FrancisCrickInstitute/Four_channel_syringe_pump/README.md

# Four_channel_syringe_pump

Four-channel syringe pump with radial distribution for 10 mL syringes

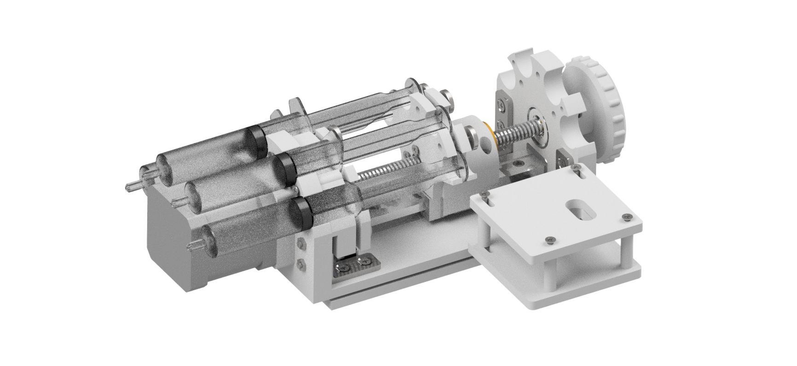
[picture p1: Design files/Inventor/Four channel pump assembly render 1.png]
