FrancisCrickInstitute/Four_channel_syringe_pump/Figures/Figure 1.png

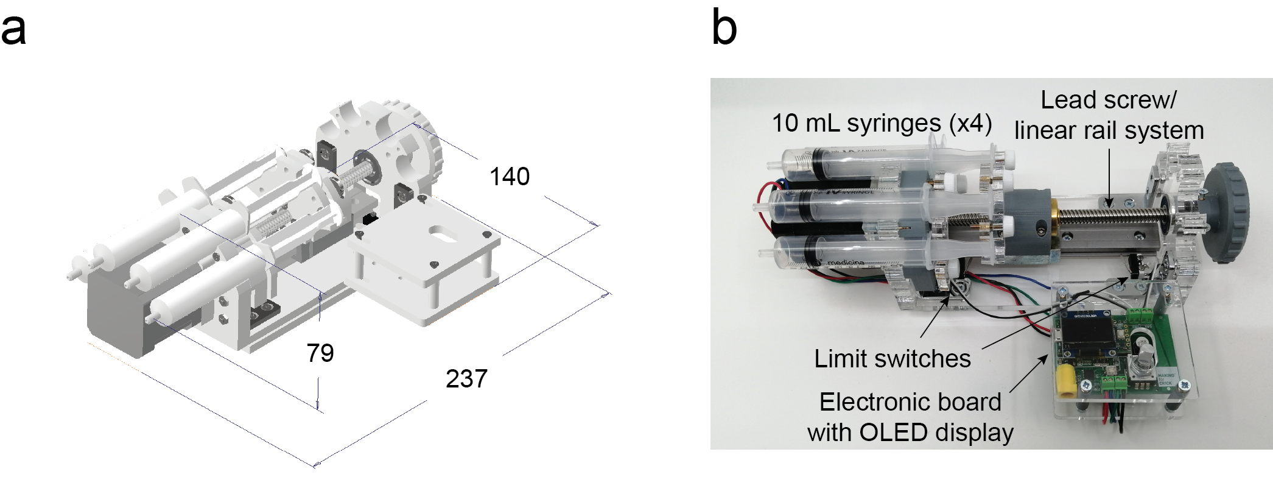
Figures/Figure 1.png
