FrancisCrickInstitute/Four_channel_syringe_pump/Figures/Figure 2.png

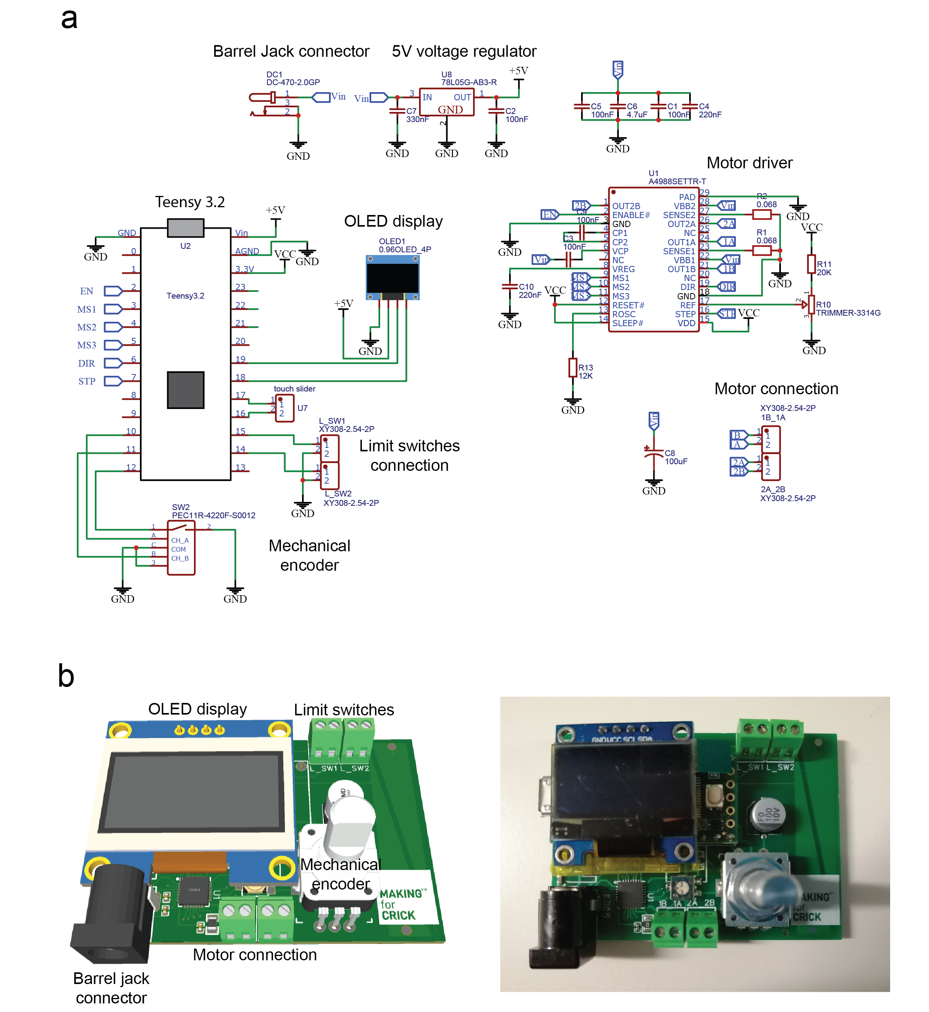
Figures/Figure 2.png
