FrancisCrickInstitute/Four_channel_syringe_pump/Figures/Figure 3.png

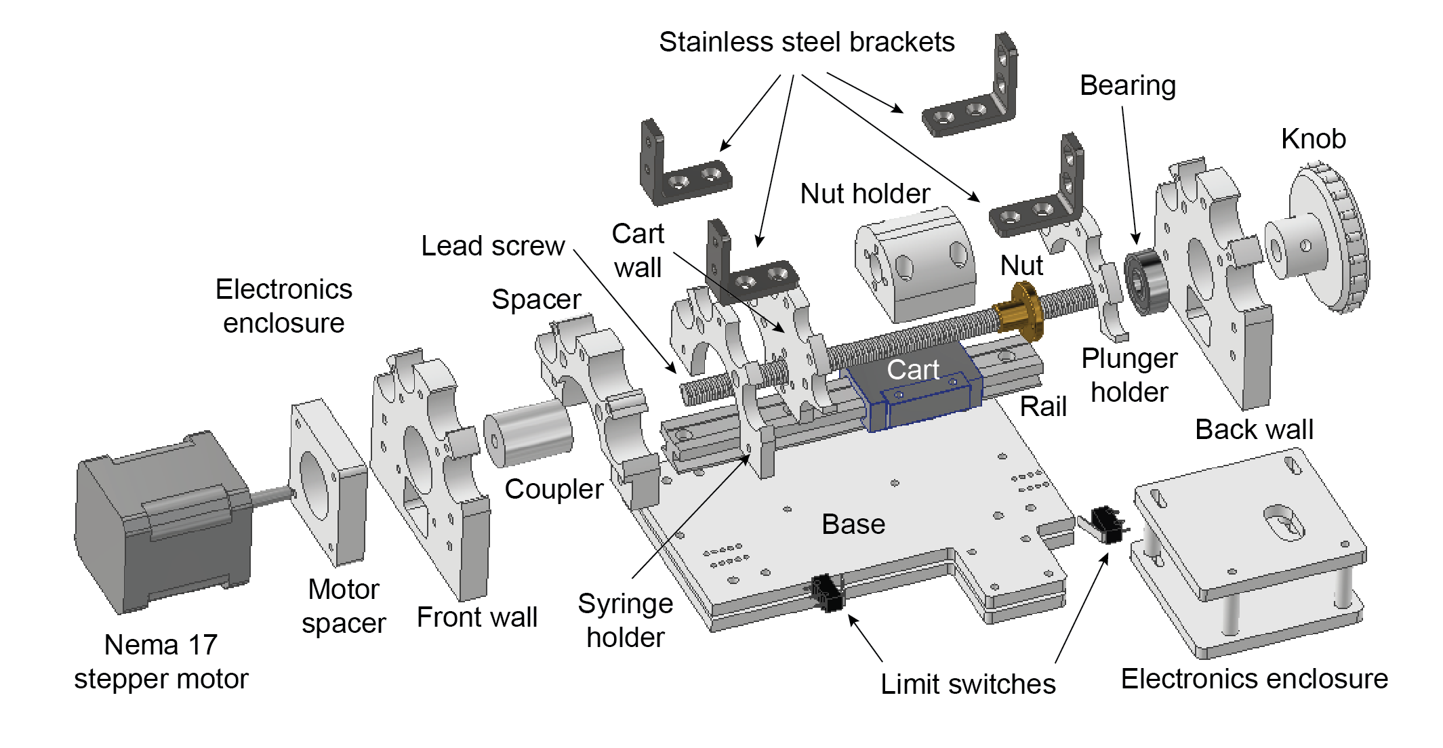
Figures/Figure 3.png
