FrancisCrickInstitute/Four_channel_syringe_pump/Figures/Figure 4(2).png

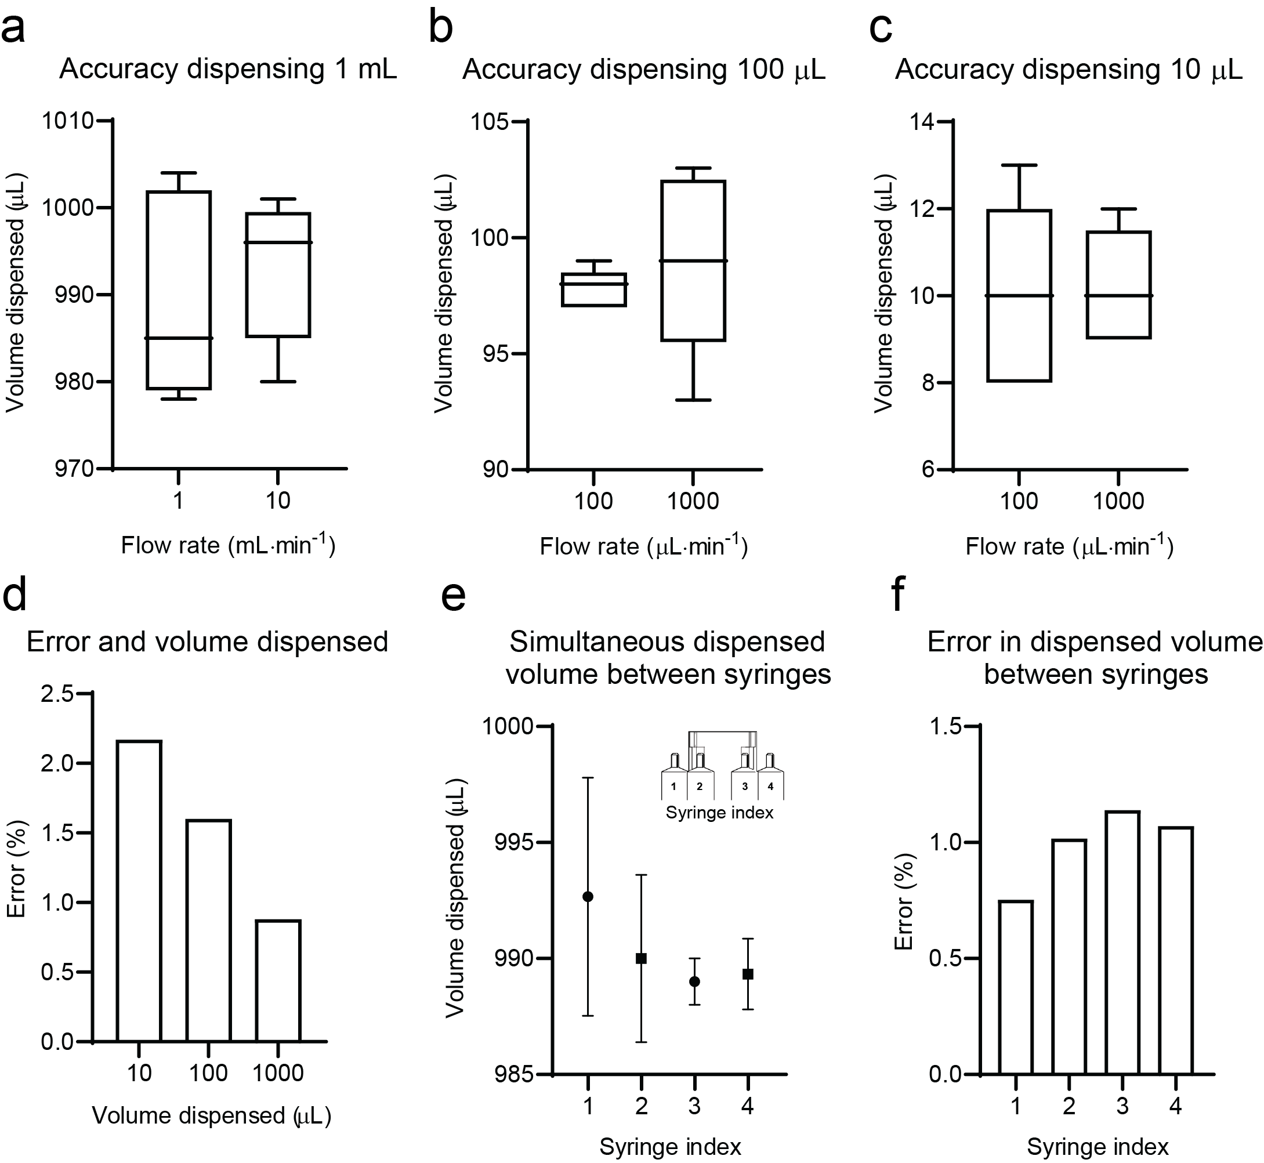
Figures/Figure 4(2).png
