FrancisCrickInstitute/Four_channel_syringe_pump/Figures/Figure 5.png

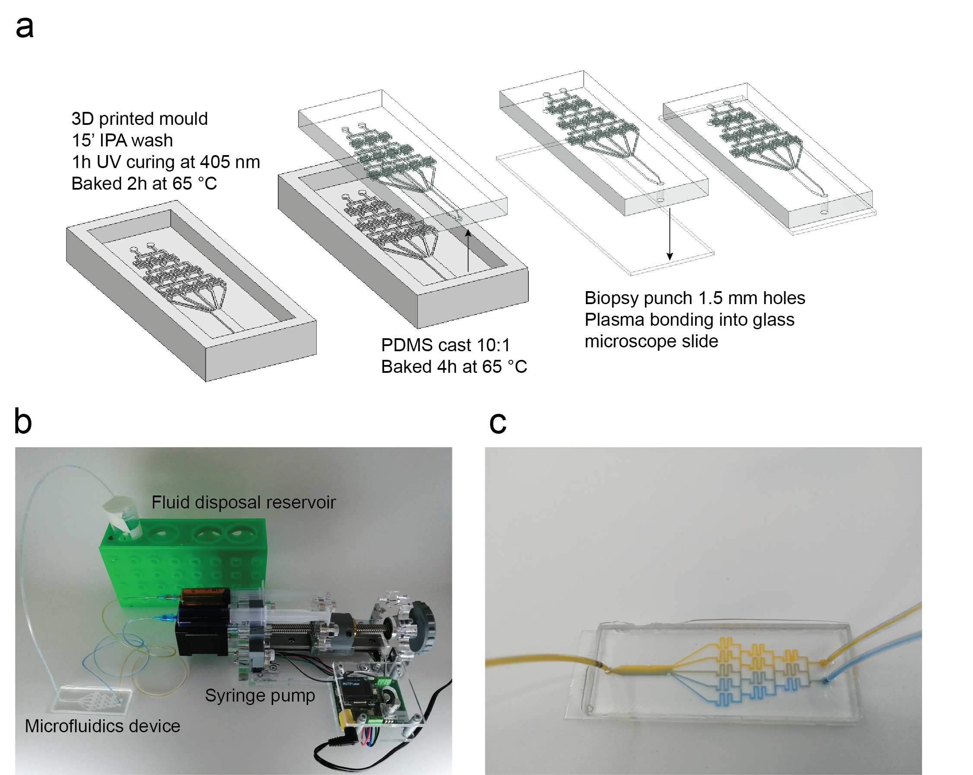
Figures/Figure 5.png
