FrancisCrickInstitute/Four_channel_syringe_pump/Figures/IMG_20210123_194944.jpg

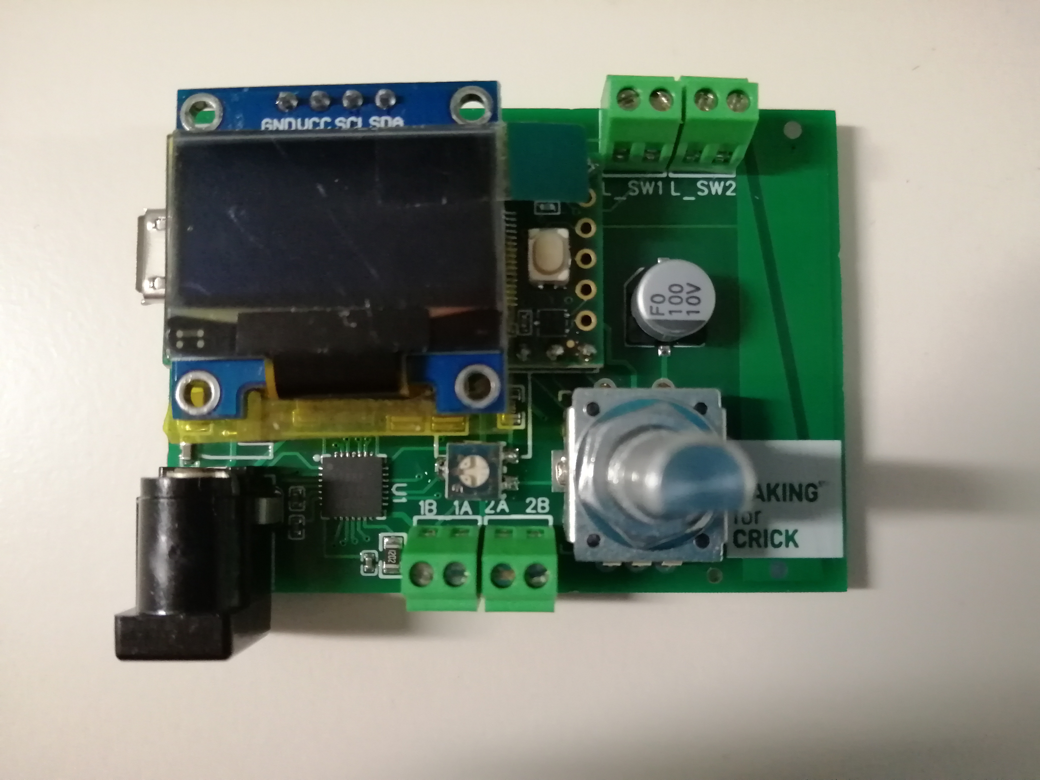
Figures/IMG_20210123_194944.jpg
