FrancisCrickInstitute/Four_channel_syringe_pump/Figures/IMG_20220202_103747.jpg

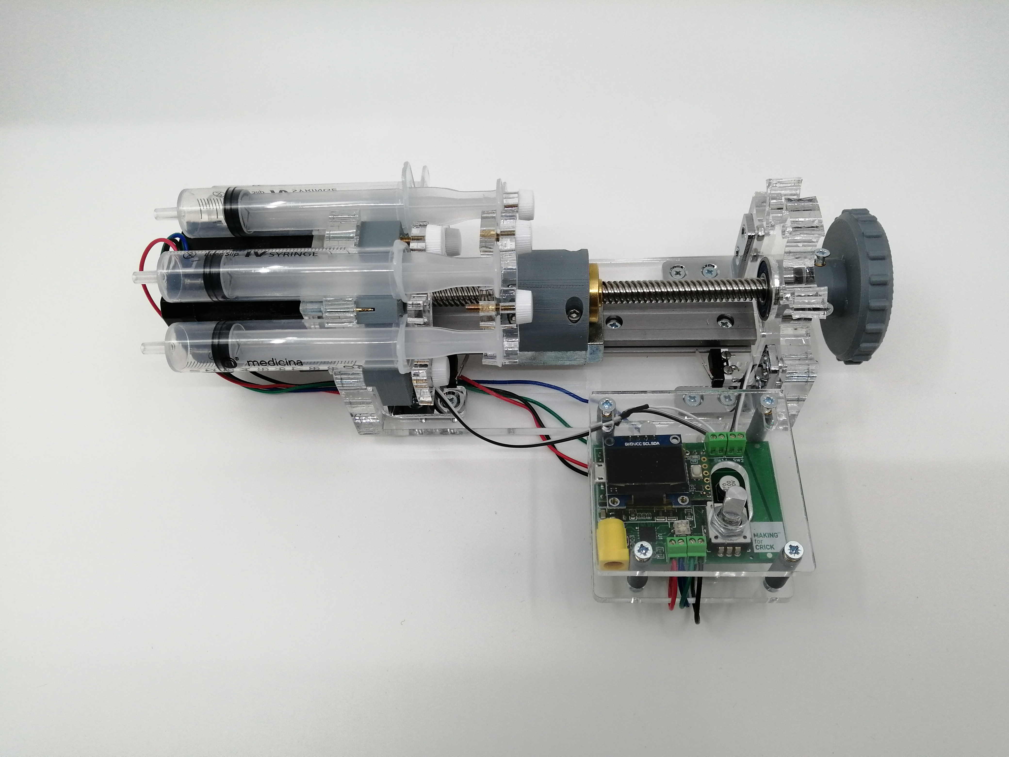
Figures/IMG_20220202_103747.jpg
