FrancisCrickInstitute/Four_channel_syringe_pump/Figures/IMG_20220818_093151.jpg

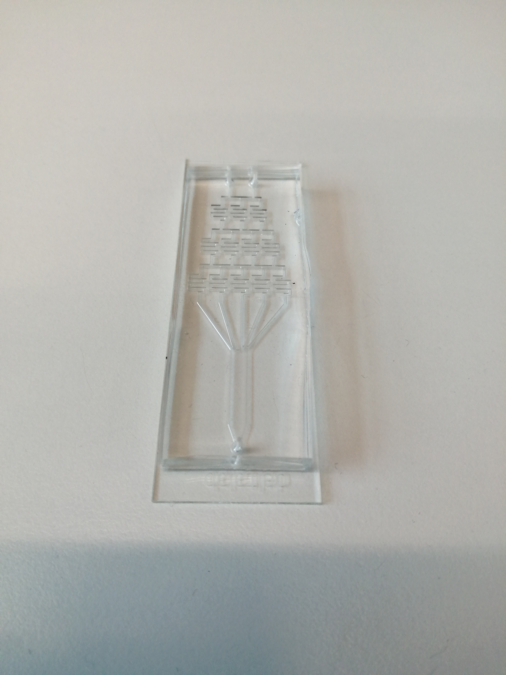
Figures/IMG_20220818_093151.jpg
