FrancisCrickInstitute/Four_channel_syringe_pump/Figures/IMG_20220916_155612.jpg

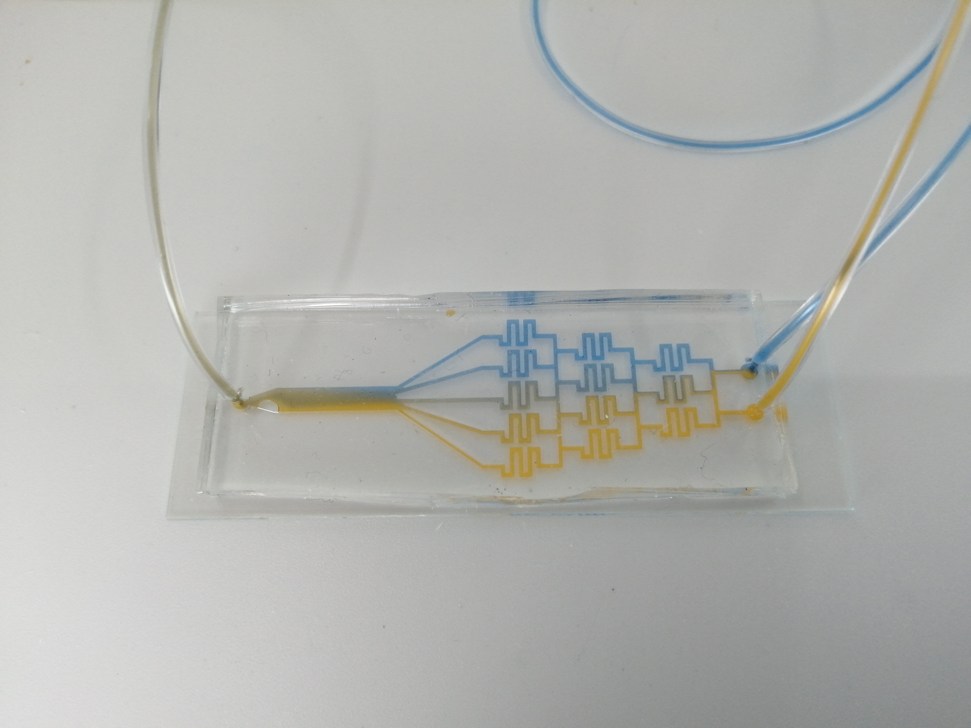
Figures/IMG_20220916_155612.jpg
