FrancisCrickInstitute/Four_channel_syringe_pump/Figures/IMG_20220930_113244.jpg

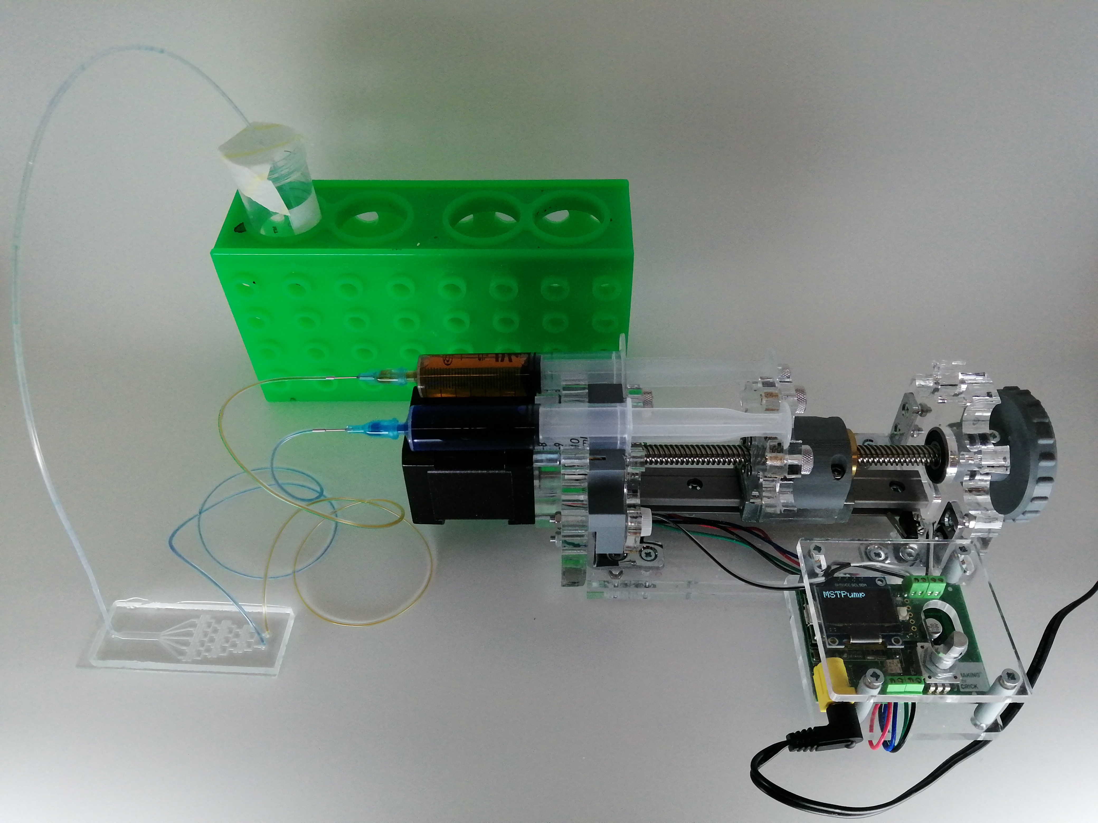
Figures/IMG_20220930_113244.jpg
