FrancisCrickInstitute/Four_channel_syringe_pump/Figures/IMG_20220930_121132.jpg

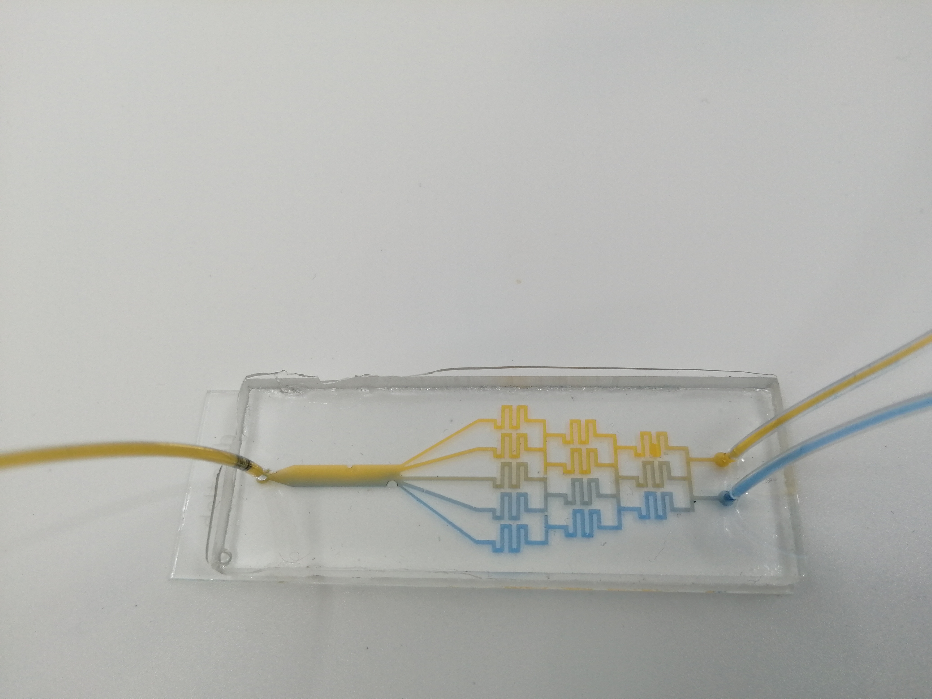
Figures/IMG_20220930_121132.jpg
