FrancisCrickInstitute/Four_channel_syringe_pump/Figures/Microfluidics gradient.png

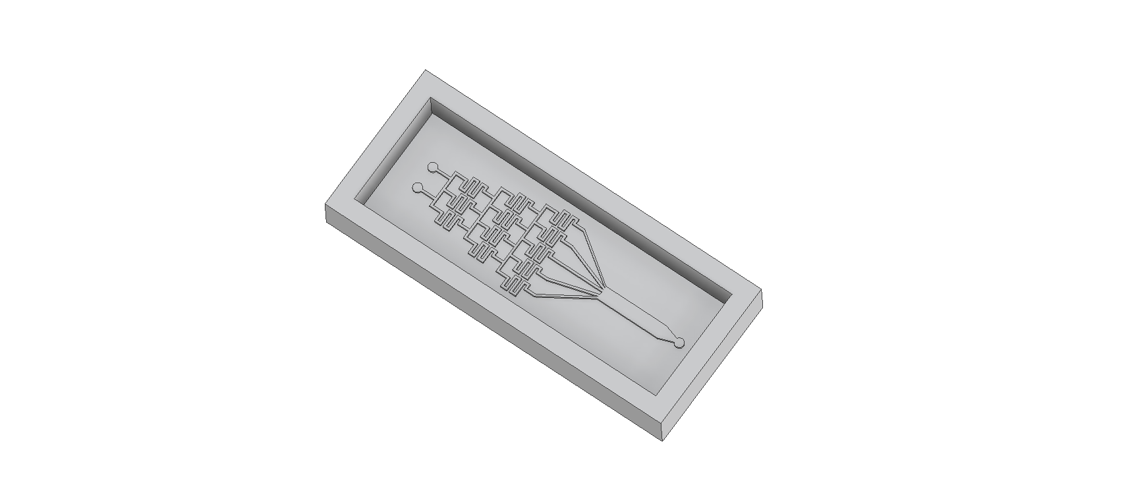
Figures/Microfluidics gradient.png
