FrancisCrickInstitute/Four_channel_syringe_pump/Bill of materials/Bill of materials.xlsx

Component | Units | Manufacturer Hyperlink embedded) | Unit cost £ | Cost £
Rail | 1 | RS Components (https://uk.rs-online.com/web/p/linear-guides-rails/4885079/) | 21.22 | 21.22
Carriage | 1 | RS Components (https://uk.rs-online.com/web/p/linear-guide-blocks/4884997/) | 24.30 | 24.30
Bracket | 4 | RS Components (https://uk.rs-online.com/web/p/enclosure-mounting-brackets/7491686) | 2.93 | 11.73
M3 threaded insert | 17 | RS Components (https://uk.rs-online.com/web/p/threaded-inserts/0278534) | 0.13 | 2.21
M3 thumb screw | 6 | RS Components (https://uk.rs-online.com/web/p/thumb-screws/6644892) | 0.14 | 0.83
Potentiometer 10k | 1 | RS Components (https://uk.rs-online.com/web/p/trimmer-potentiometers/4867526?matchtype=&pla-531626548992) | 1.45 | 1.45
Rotary encoder | 1 | RS Components (https://uk.rs-online.com/web/p/mechanical-rotary-encoders/7816830) | 1.62 | 1.62
M3 40 mm screws | 8 | Amazon (https://www.amazon.co.uk/40mm-Slot-Countersunk-Machine-Screw/dp/B07MY6HNMK) | 0.30 | 2.40
AC/DC Converter | 1 | Amazon (https://www.amazon.co.uk/Adapter-Converter-Driver-100-240V-Transformer/dp/B09DYDRFKZ) | 6.59 | 6.59
Micro Switch | 2 | Amazon (https://www.amazon.co.uk/gp/product/B07YDFH7H3/ref=ppx_yo_dt_b_asin_title_o07_s02?ie=UTF8&psc=1) | 0.30 | 0.60
OLED Display | 1 | Amazon (https://www.amazon.co.uk/gp/product/B01L9GC470/ref=ppx_yo_dt_b_asin_title_o01_s00?ie=UTF8&psc=1) | 4.99 | 4.99
Lead screw + nut (1mm) (Option B) | 1 | Amazon (https://www.amazon.co.uk/gp/product/B08M36BWMP/ref=ppx_yo_dt_b_asin_title_o02_s00?ie=UTF8&th=1) | 14.80 | 14.80
Lead screw + nut (8mm) (Option A) | 1 | Amazon (https://www.amazon.co.uk/gp/product/B07P6HQMHT/ref=ppx_yo_dt_b_asin_title_o03_s00?ie=UTF8&th=1) | 14.99 | 14.99
Coupler | 1 | Amazon (https://www.amazon.co.uk/gp/product/B0783QQMKP/ref=ppx_yo_dt_b_asin_title_o03_s00?ie=UTF8&psc=1) | 5.74 | 5.74
Nema 17 stepper motor | 1 | Amazon (https://www.amazon.co.uk/JoyNano-Stepper-Bipolar-Holding-2-Phase/dp/B07DPFP4ZK?s=industrial) | 14.99 | 14.99
Bearing | 1 | Amazon (https://www.amazon.co.uk/CODIRATO-Skateboard-Bearings-Longboard-Skateboards/dp/B07TB6Y9ZK?pd_r) | 0.45 | 0.45
Teensy 3.2 | 1 | Amazon (https://www.amazon.co.uk/Teensy-3-2-Without-Pins/dp/B018EFDXT2) | 22.99 | 22.99
M2/M3 screws | 1 | Amazon (https://www.amazon.co.uk/Loscrew-Stainless-Hexagonal-Countersunk-Assortment/dp/B08MQ8VM89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) | 21.99 | 21.99
Screw connectors | 4 | Amazon (https://www.amazon.co.uk/UCTOP-STORE-2-54mm-Terminal-Connector/dp/B01FS4KDN6) | 0.33 | 1.33
2.54 mm Female pin header | 2 | Amazon (https://www.amazon.co.uk/HALJIA-Header-Connector-2-54mm-StripWires/dp/B06WD34L1H) | 0.50 | 1.00
Barrel jack | 1 | Amazon (https://www.amazon.co.uk/Bottam-Power-Socket-2-1mm-Barrel-Type/dp/B09MQTLXJK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) | 0.10 | 0.10
Assembled PCB | 1 | Gerber file (JCB PCB) (https://cart.jlcpcb.com/quote?orderType=1&stencilLayer=2&stencilWidth=100&stencilLength=100) | 10.00 | 10.00
Spacer | 1 | 3D printed | 2.10 | 2.10 | Corresponds to 70g of filament required on our slicer simulation to print the four parts
Electronics spacer | 4 | 3D printed
Nut holder | 1 | 3D printed
Knob | 1 | 3D printed
Back wall | 2 | Laser cut/3D printed (https://www.sheetplastics.co.uk/5mm-clear-acrylic-sheet-cut-to-size) | 9.36 | 9.36 | Corresponds to a 500 x 300 mm x 5 mm Acrylic sheet needed to manufacture the parts
Base | 2 | Laser cut/3D printed
Syringe holder | 1 | Laser cut/3D printed
Plunge holder | 1 | Laser cut/3D printed
Motor spacer | 2 | Laser cut/3D printed
Front wall | 2 | Laser cut/3D printed
Electronics base | 1 | Laser cut/3D printed
Electronics cover | 1 | Laser cut/3D printed
Cart wall | 1 | Laser cut/3D printed
 |  |  | Total cost | 182.78
