FrancisCrickInstitute/Four_channel_syringe_pump/Assembly instructions/Assembly parts.png

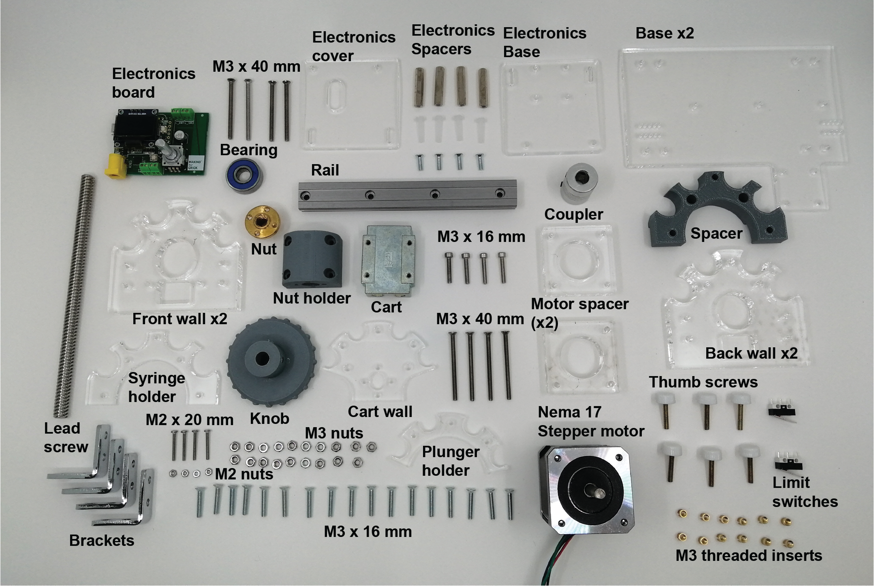
Assembly instructions/Assembly parts.png
