FrancisCrickInstitute/Four_channel_syringe_pump/Gradient chip/Microfluidics gradient.stl

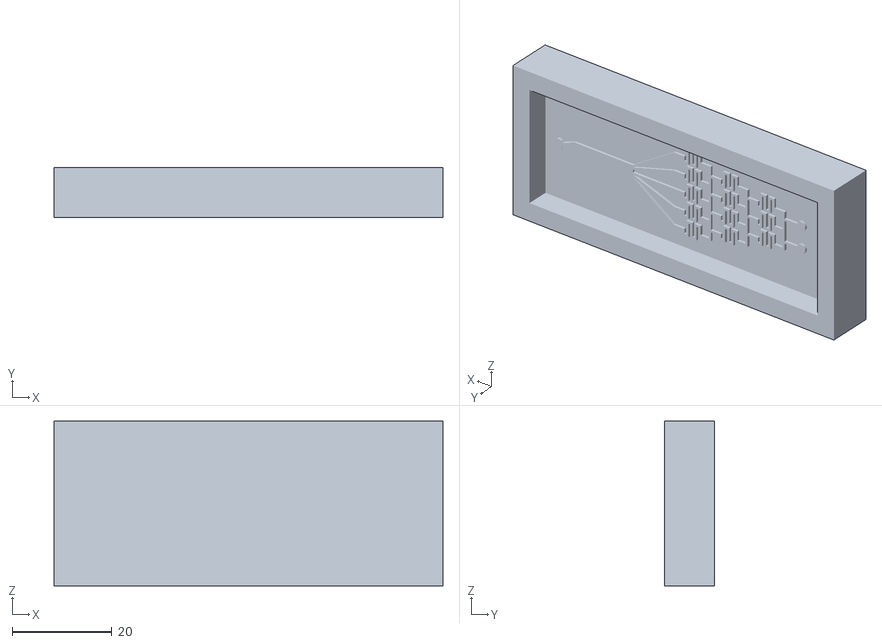
[picture p17: CAD file, 2022-09-30]
Gradient chip/Microfluidics gradient.stl
78.0 x 10.0 x 33.0
