FrancisCrickInstitute/Four_channel_syringe_pump/Manufacturing files/Mechanics/STL/Motor spacer.stl

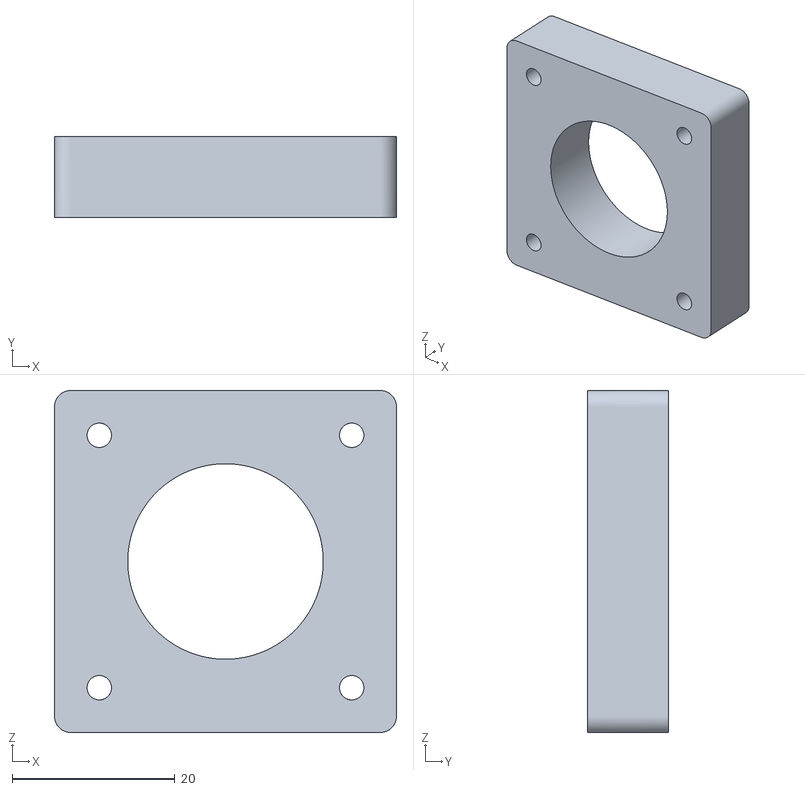
[picture p18: CAD file, 2022-02-14]
Manufacturing files/Mechanics/STL/Motor spacer.stl
42.0 x 10.0 x 42.0
