FrancisCrickInstitute/Four_channel_syringe_pump/Manufacturing files/Mechanics/STL/Cart wall.stl

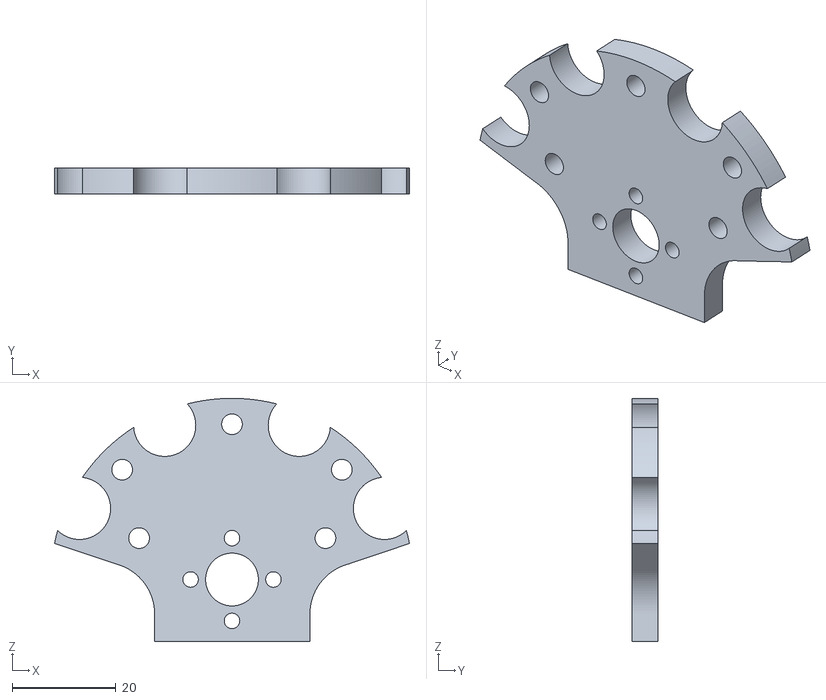
[picture p19: CAD file, 2022-02-14]
Manufacturing files/Mechanics/STL/Cart wall.stl
68.6 x 5.10 x 47.0
