FrancisCrickInstitute/Four_channel_syringe_pump/Manufacturing files/Mechanics/STL/Bracket .stl

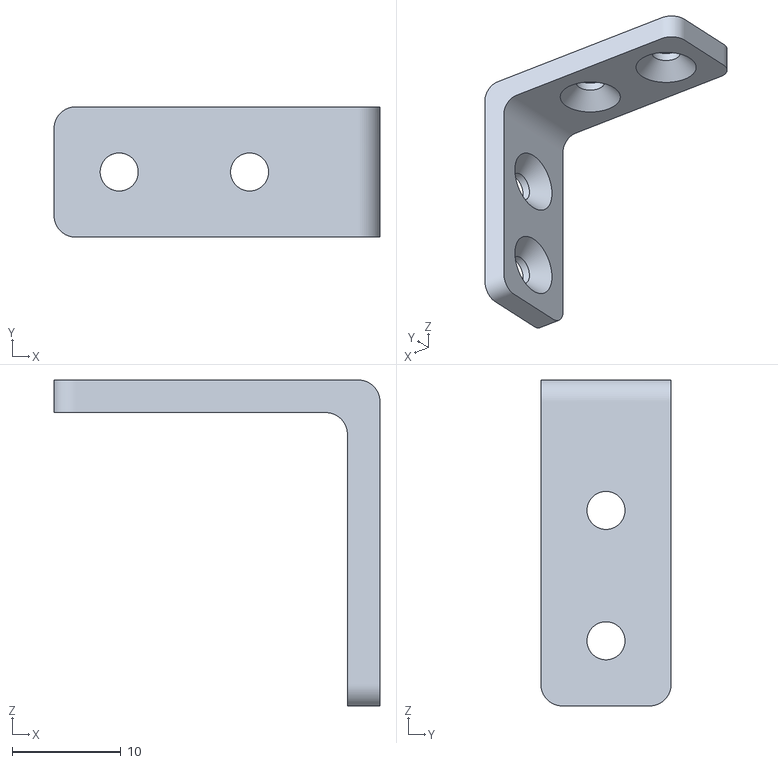
[picture p21: CAD file, 2022-02-14]
Manufacturing files/Mechanics/STL/Bracket .stl
30.0 x 12.0 x 30.0
