FrancisCrickInstitute/Four_channel_syringe_pump/Manufacturing files/Mechanics/STL/Front wall.stl

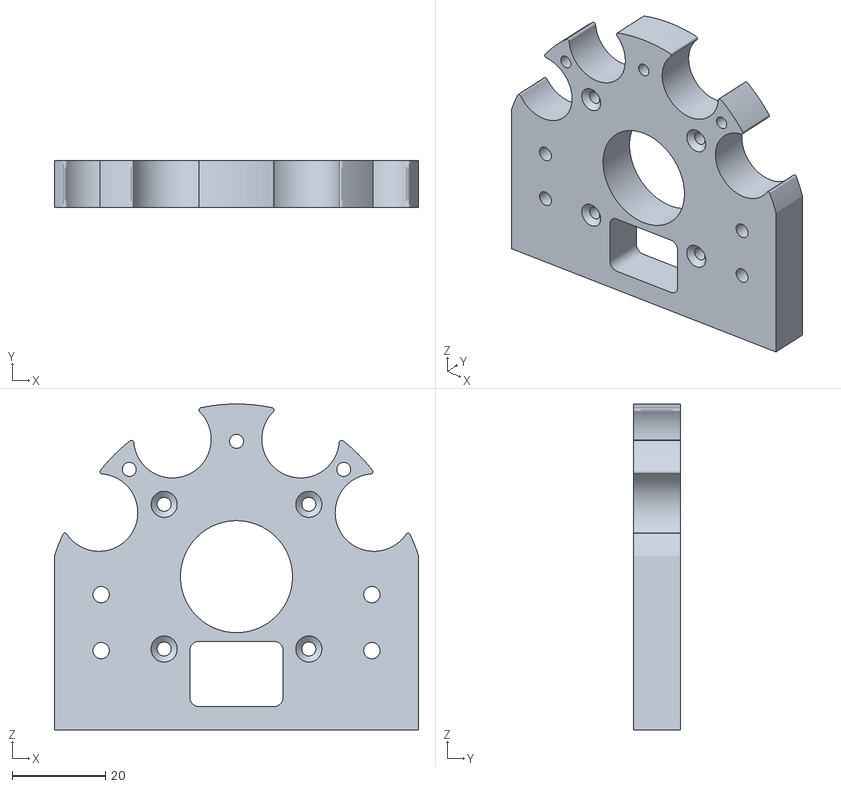
[picture p22: CAD file, 2022-02-14]
Manufacturing files/Mechanics/STL/Front wall.stl
78.0 x 10.0 x 69.8
