FrancisCrickInstitute/Four_channel_syringe_pump/Manufacturing files/Mechanics/STL/Plunger Holder.stl

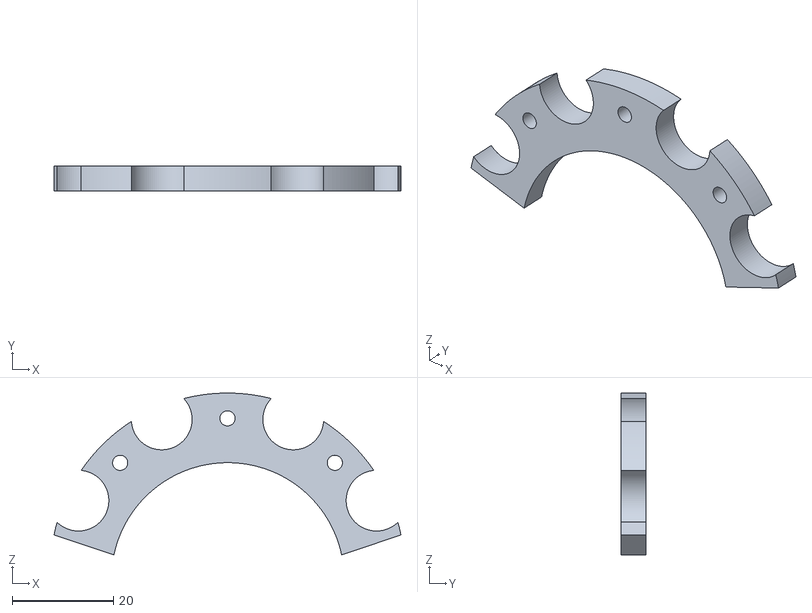
[picture p23: CAD file, 2022-02-14]
Manufacturing files/Mechanics/STL/Plunger Holder.stl
68.6 x 5.00 x 32.0
