FrancisCrickInstitute/Four_channel_syringe_pump/Manufacturing files/Mechanics/STL/Syringe Holder.stl

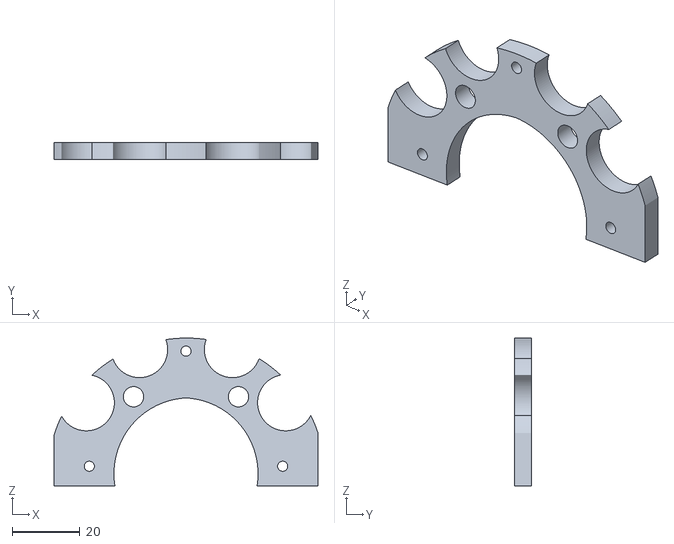
[picture p24: CAD file, 2022-02-14]
Manufacturing files/Mechanics/STL/Syringe Holder.stl
78.0 x 5.00 x 43.7
