FrancisCrickInstitute/Four_channel_syringe_pump/Manufacturing files/Mechanics/STL/Electronics base.stl

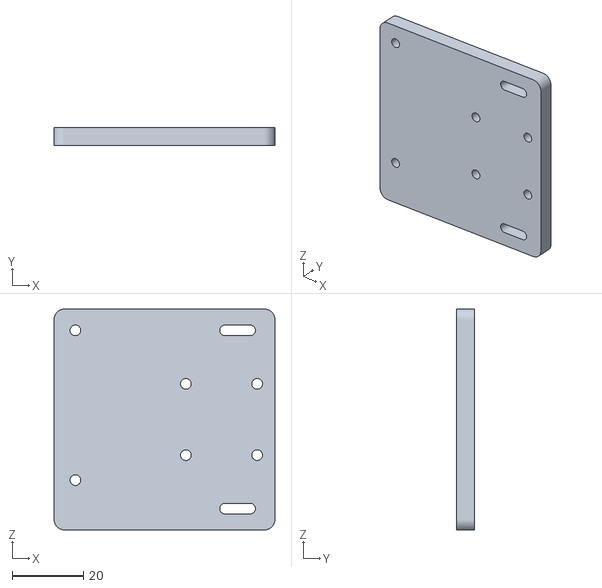
[picture p25: CAD file, 2022-02-14]
Manufacturing files/Mechanics/STL/Electronics base.stl
62.0 x 5.00 x 62.0
