FrancisCrickInstitute/Four_channel_syringe_pump/Manufacturing files/Mechanics/STL/Spacer.stl

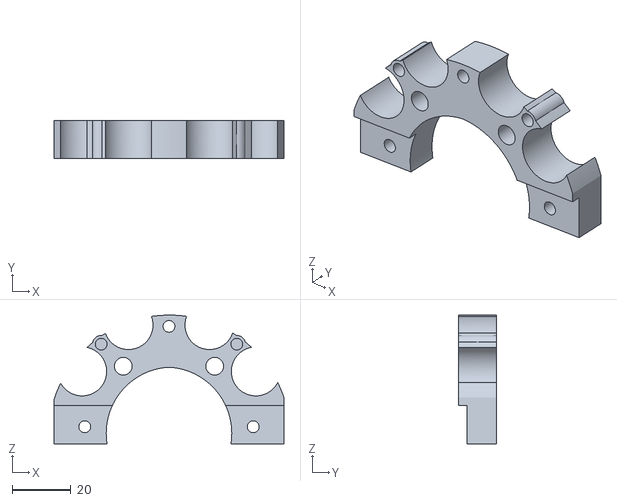
[picture p26: CAD file, 2022-02-14]
Manufacturing files/Mechanics/STL/Spacer.stl
78.0 x 13.0 x 43.7
