FrancisCrickInstitute/Four_channel_syringe_pump/Manufacturing files/Mechanics/STL/Electronics cover.stl

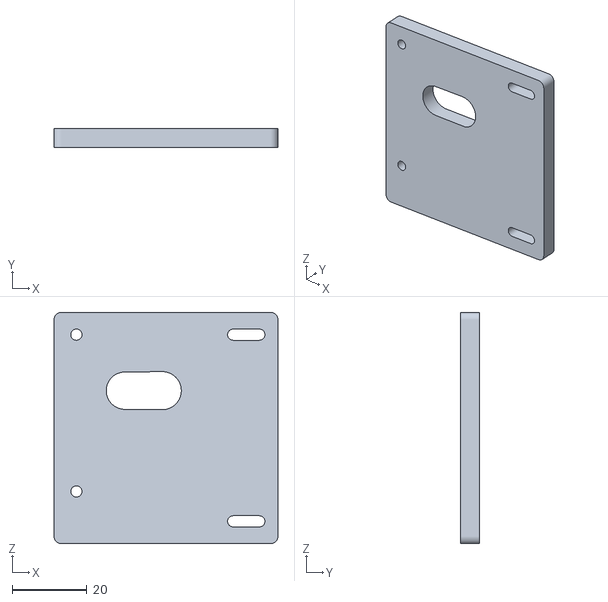
[picture p27: CAD file, 2022-02-14]
Manufacturing files/Mechanics/STL/Electronics cover.stl
60.0 x 5.00 x 62.0
