FrancisCrickInstitute/Four_channel_syringe_pump/Manufacturing files/Mechanics/STL/Knob.stl

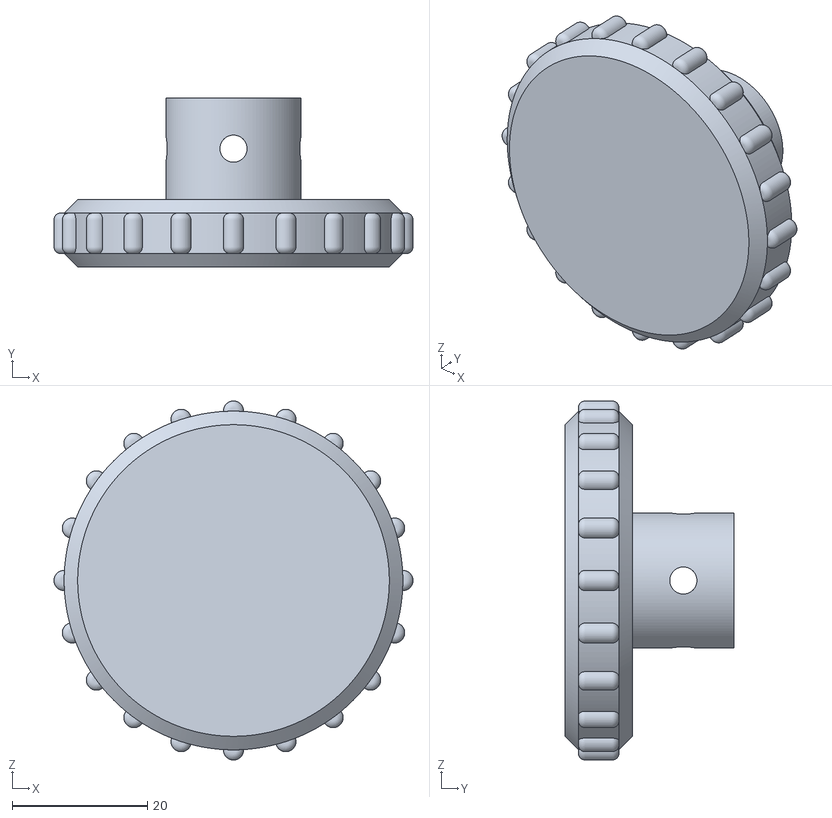
[picture p28: CAD file, 2022-02-13]
Manufacturing files/Mechanics/STL/Knob.stl
53.0 x 25.0 x 53.0
