FrancisCrickInstitute/Four_channel_syringe_pump/Manufacturing files/Mechanics/STL/Electronics spacer.stl

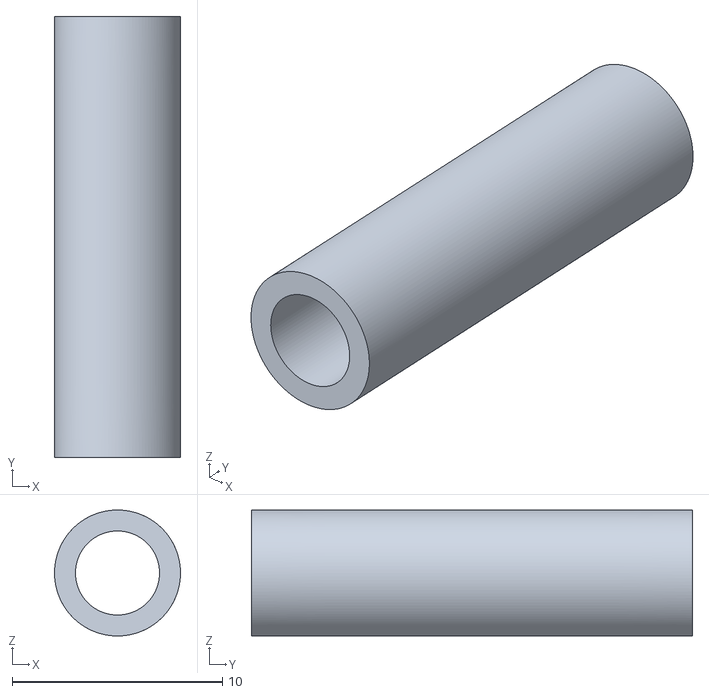
[picture p29: CAD file, 2022-02-13]
Manufacturing files/Mechanics/STL/Electronics spacer.stl
6.00 x 21.0 x 6.00
