FrancisCrickInstitute/Four_channel_syringe_pump/Manufacturing files/Mechanics/STL/Nut holder.stl

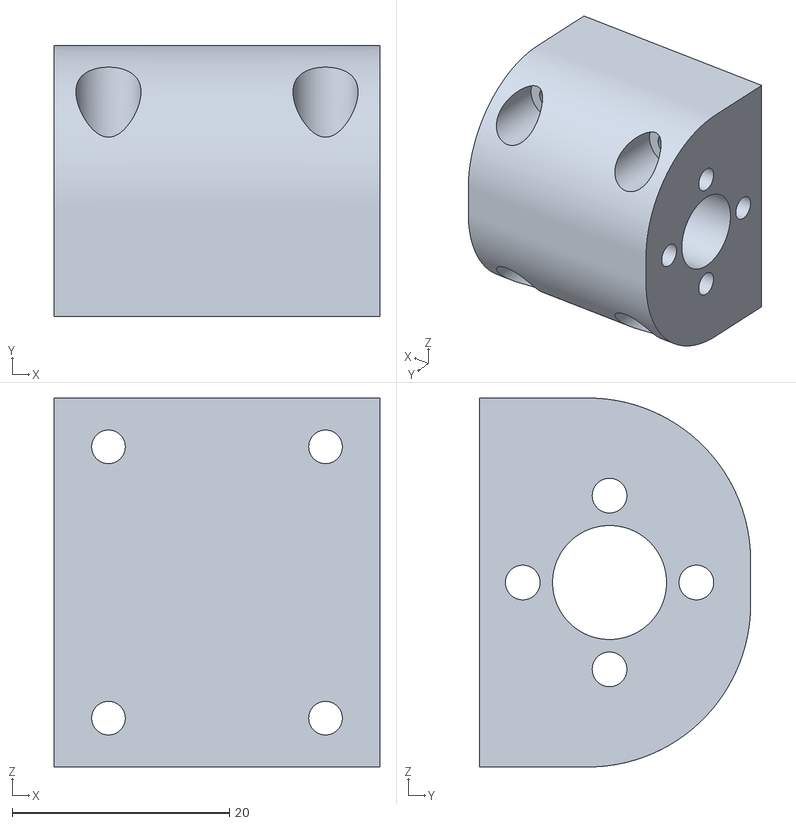
[picture p30: CAD file, 2022-02-14]
Manufacturing files/Mechanics/STL/Nut holder.stl
30.0 x 25.0 x 34.0
