FrancisCrickInstitute/Four_channel_syringe_pump/(list of files, cad)

Other CAD files:
Manufacturing files/Mechanics/STL/Back wall.stl
Design files/Inventor/10 mL syringe plunger.ipt
Design files/Inventor/10 mL syringe.ipt
Design files/Inventor/Back wall.ipt
Design files/Inventor/Base.ipt
Design files/Inventor/Bearing.ipt
Design files/Inventor/Bracket .ipt
Design files/Inventor/Cart wall.ipt
Design files/Inventor/Cart.ipt
Design files/Inventor/Coupler.ipt
Design files/Inventor/Electronics base.ipt
Design files/Inventor/Electronics cover.ipt
Design files/Inventor/Electronics spacer.ipt
Design files/Inventor/Four channel pump assembly.iam
Design files/Inventor/Four channel pump assembly.ipn
Design files/Inventor/Front wall.ipt
Design files/Inventor/Knob.ipt
Design files/Inventor/Lead screw.ipt
Design files/Inventor/Microswitch.ipt
Design files/Inventor/Motor spacer.ipt
Design files/Inventor/Nut holder.ipt
Design files/Inventor/Nut.ipt
Design files/Inventor/OldVersions/10 mL syringe plunger.0001.ipt
Design files/Inventor/OldVersions/10 mL syringe plunger.0003.ipt
Design files/Inventor/OldVersions/10 mL syringe plunger.0004.ipt
Design files/Inventor/OldVersions/10 mL syringe.0002.ipt
Design files/Inventor/OldVersions/Base.0002.ipt
Design files/Inventor/OldVersions/Cart.0001.ipt
Design files/Inventor/OldVersions/Coupler.0001.ipt
Design files/Inventor/OldVersions/Four channel pump assembly.0002.ipn
Design files/Inventor/OldVersions/Four channel pump assembly.0031.iam
Design files/Inventor/OldVersions/Front wall.0001.ipt
Design files/Inventor/OldVersions/Knob.0003.ipt
Design files/Inventor/OldVersions/Lead screw.0004.ipt
Design files/Inventor/OldVersions/Spacer.0002.ipt
Design files/Inventor/OldVersions/Syringe Holder.0001.ipt
Design files/Inventor/Plunger Holder.ipt
Design files/Inventor/Rail.ipt
Design files/Inventor/Spacer.ipt
Design files/Inventor/Stepper motor (Nema 17).ipt
Design files/Inventor/Syringe Holder.ipt
Gradient chip/Assembly1.iam
Gradient chip/Microfluidics gradient PDMS with ports.ipt
Gradient chip/Microfluidics gradient PDMS.ipt
Gradient chip/Microfluidics gradient.ipt
Gradient chip/Microscope slide.ipt
Gradient chip/OldVersions/Assembly1.0001.iam
Gradient chip/OldVersions/Microfluidics gradient PDMS.0002.ipt
Gradient chip/OldVersions/Microfluidics gradient substratr.0001.ipt
Gradient chip/OldVersions/Microfluidics gradient.0019.ipt
Gradient chip/OldVersions/Microscope slide.0002.ipt
Manufacturing files/Mechanics/DXF/Back wall.dxf
Manufacturing files/Mechanics/DXF/Base.dxf
Manufacturing files/Mechanics/DXF/Cart wall.dxf
Manufacturing files/Mechanics/DXF/Electronics base.dxf
Manufacturing files/Mechanics/DXF/Electronics cover.dxf
Manufacturing files/Mechanics/DXF/Front wall.dxf
Manufacturing files/Mechanics/DXF/Motor spacer.dxf
Manufacturing files/Mechanics/DXF/Plunger holder.dxf
Manufacturing files/Mechanics/DXF/Syringe holder.dxf
