FrancisCrickInstitute/Four_channel_syringe_pump/Manufacturing files/Electronics/Gerber/Gerber_PCB/How-to-order-PCB.txt

How to Order PCB

Please refer to:
https://docs.easyeda.com/en/PCB/Order-PCB
