FrancisCrickInstitute/Four_channel_syringe_pump/Assembly instructions/Assembly instructions.docx

1- Laser cut the parts in the file Manufacturing in 5 mm thickness Acrylic.ai (https://github.com/FrancisCrickInstitute/Four_channel_syringe_pump/blob/main/Manufacturing%20files/Mechanics/Adobe%20Illustrator/Manufacturing%20in%205%20mm%2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) which can be found on: https://github.com/FrancisCrickInstitute/Four_channel_syringe_pump/tree/main/Manufacturing%20files/Mechanics/Adobe%20Illustrator (Figure 1).

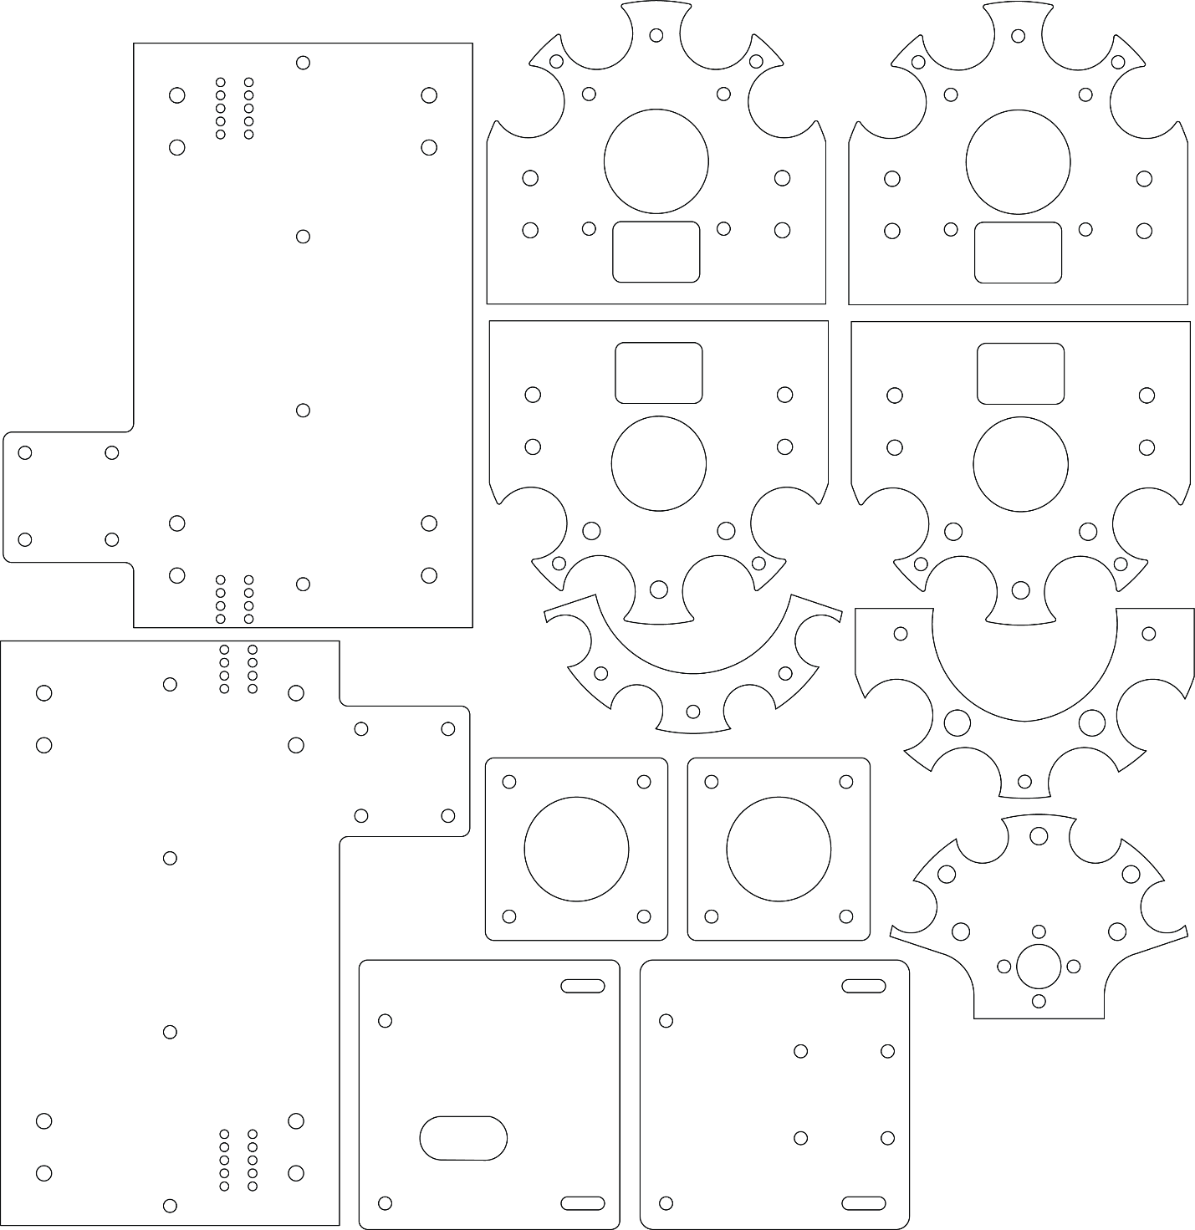
[picture p31: figure]

Figure 1: Parts to laser cut.

2- 3D print the parts (Knob.stl, Spacer.stl, Electronics spacer.stl and Nut holder.stl ) found on: https://github.com/FrancisCrickInstitute/Four_channel_syringe_pump/tree/main/Manufacturing%20files/Mechanics/STL

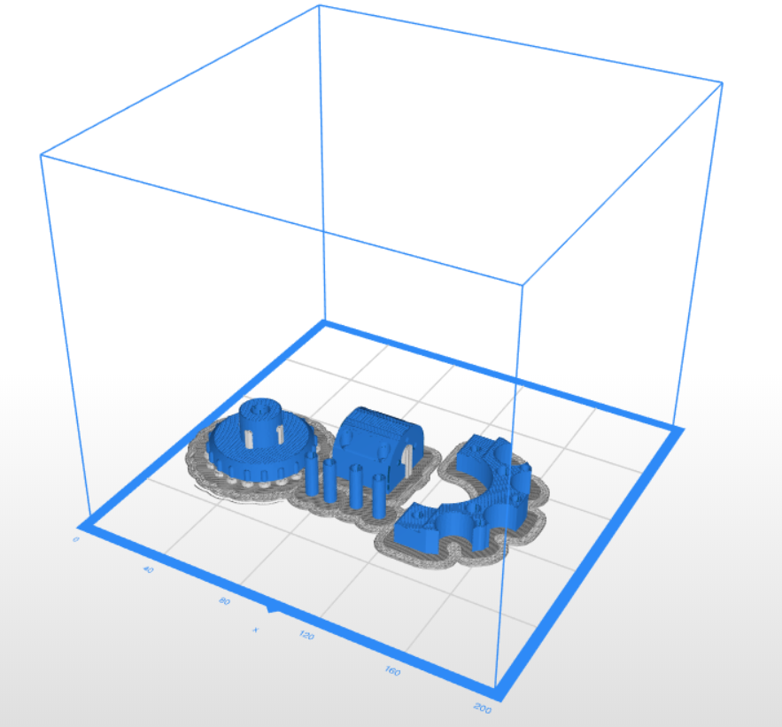
[picture p32: figure]

Figure 1: Parts to 3D print on the slicer simulation.

3- Send the electronics to manufacture:
  a. Go to JLCBPCB: https://cart.jlcpcb.com/quote?orderType=1&stencilLayer=2&stencilWidth=100&stencilLength=100
  b. Upload the Gerber files:
  c. Select SMT Assembly
  d. Upload the BOM file
  e. Upload the Pick and place file
