FrancisCrickInstitute/Four_channel_syringe_pump/Gradient chip/Assembly1.pdf

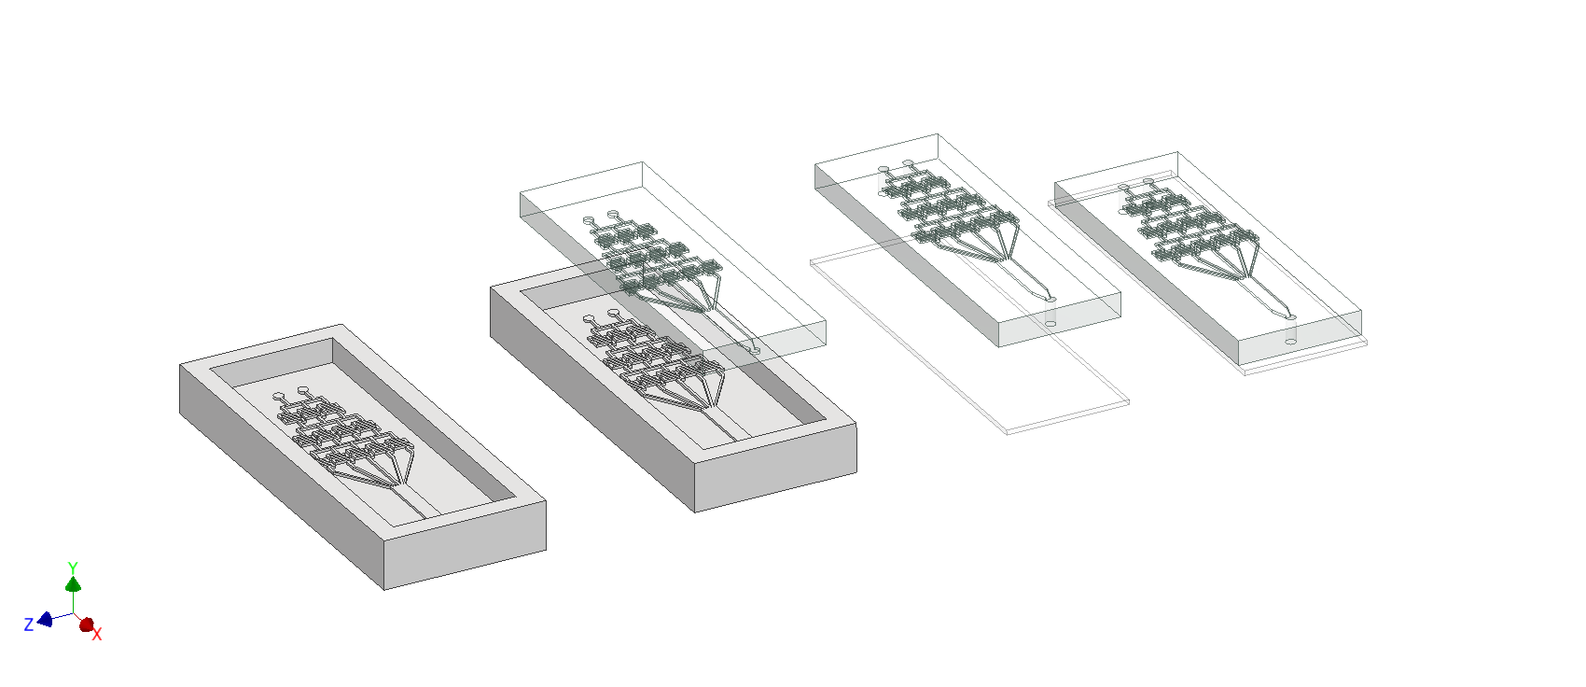
[picture p33: page 1]
