FrancisCrickInstitute/Four_channel_syringe_pump/Figures/Four channel pump assembly.pdf

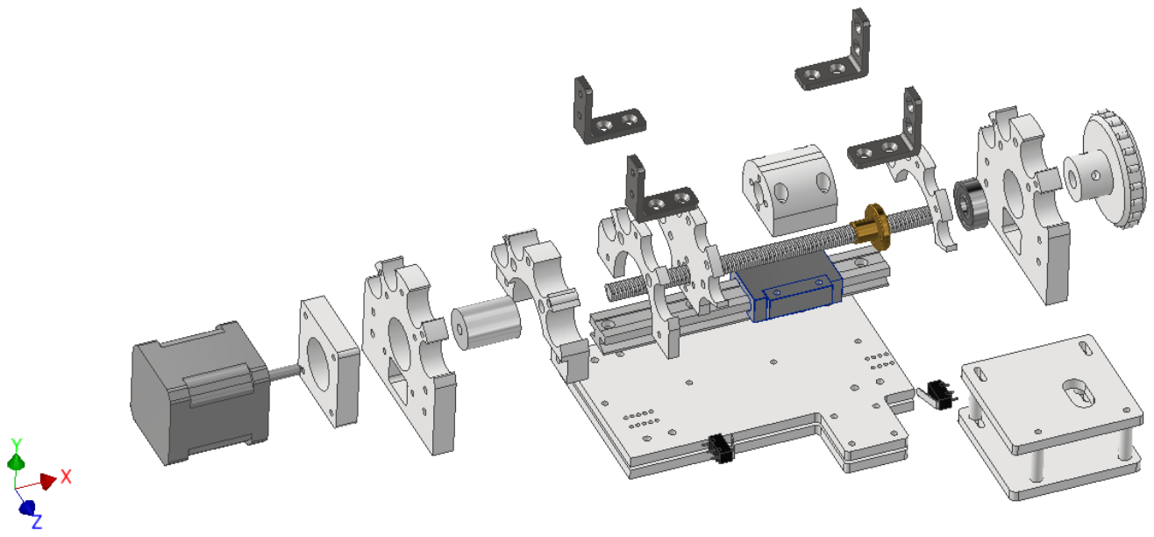
[picture p34: page 1]
