FrancisCrickInstitute/Four_channel_syringe_pump/Assembly instructions/Pictures/IMG_20220131_150504.jpg

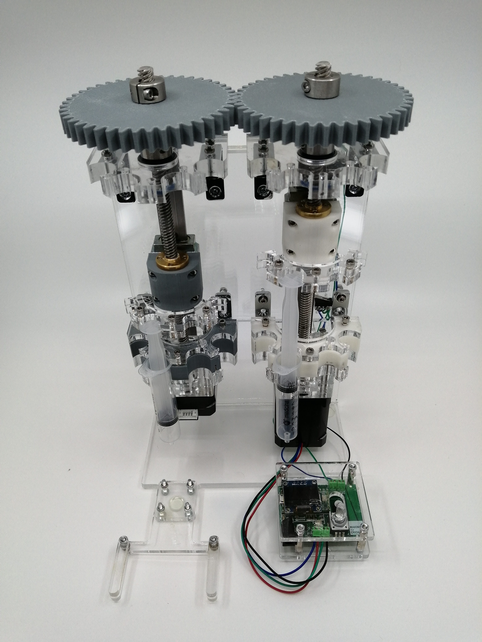
Assembly instructions/Pictures/IMG_20220131_150504.jpg
