FrancisCrickInstitute/Four_channel_syringe_pump/Assembly instructions/Pictures/IMG_20220201_115702.jpg

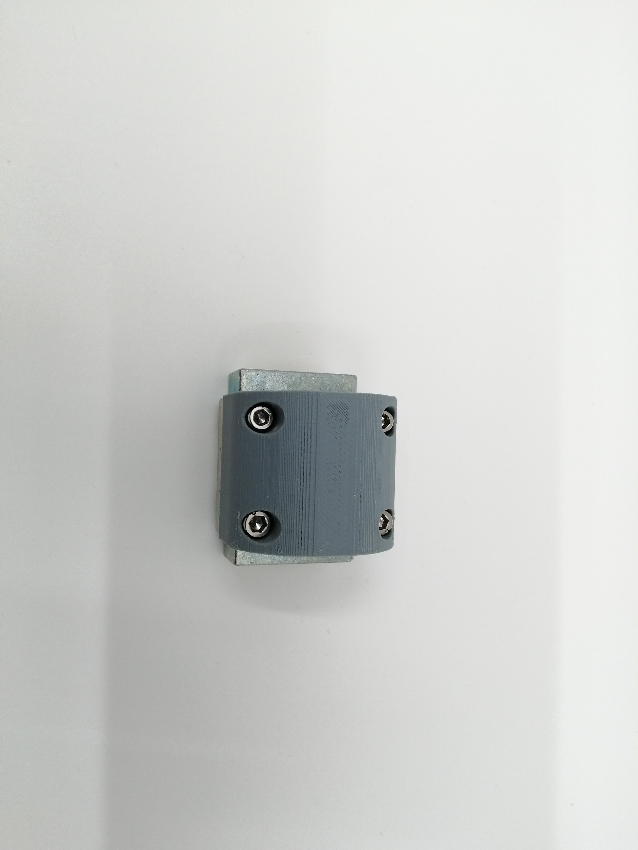
Assembly instructions/Pictures/IMG_20220201_115702.jpg
