FrancisCrickInstitute/Four_channel_syringe_pump/Assembly instructions/Pictures/IMG_20220201_121818.jpg

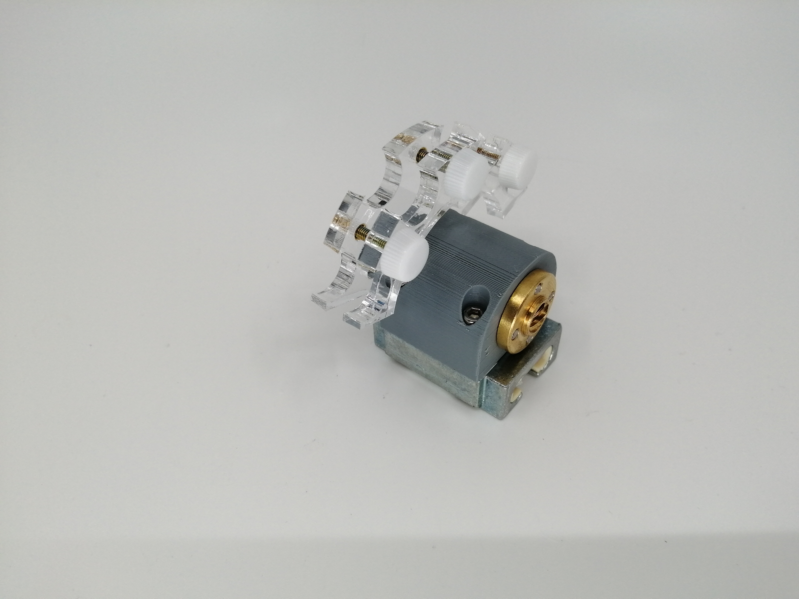
Assembly instructions/Pictures/IMG_20220201_121818.jpg
