FrancisCrickInstitute/Four_channel_syringe_pump/Assembly instructions/Pictures/IMG_20220201_134931.jpg

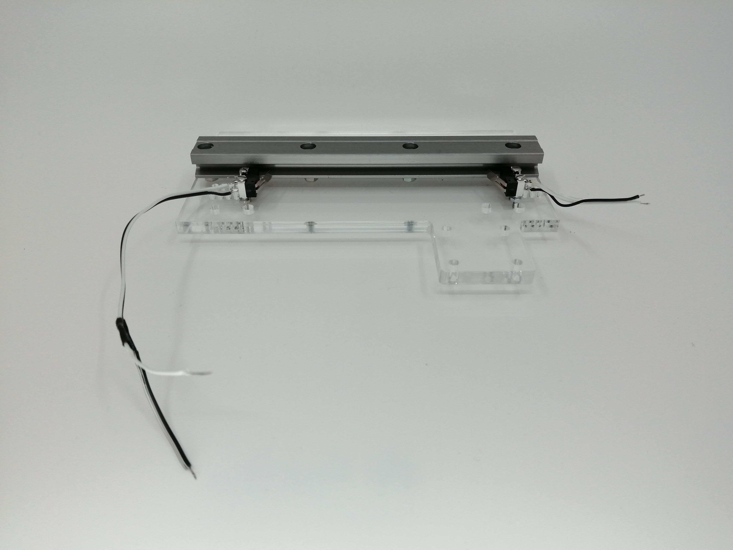
Assembly instructions/Pictures/IMG_20220201_134931.jpg
