FrancisCrickInstitute/Four_channel_syringe_pump/Assembly instructions/Pictures/IMG_20220201_173131.jpg

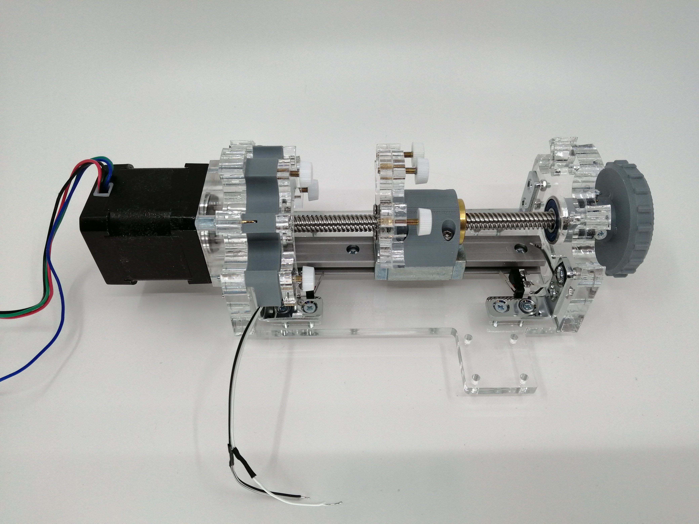
Assembly instructions/Pictures/IMG_20220201_173131.jpg
