FrancisCrickInstitute/Four_channel_syringe_pump/Assembly instructions/Pictures/IMG_20220202_101638.jpg

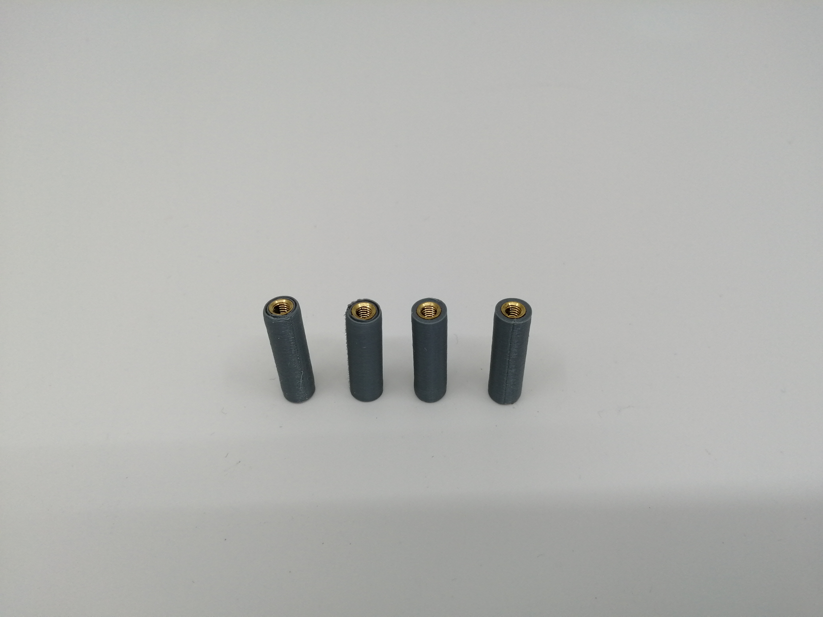
Assembly instructions/Pictures/IMG_20220202_101638.jpg
