FrancisCrickInstitute/Four_channel_syringe_pump/Assembly instructions/Threaded inserts.png

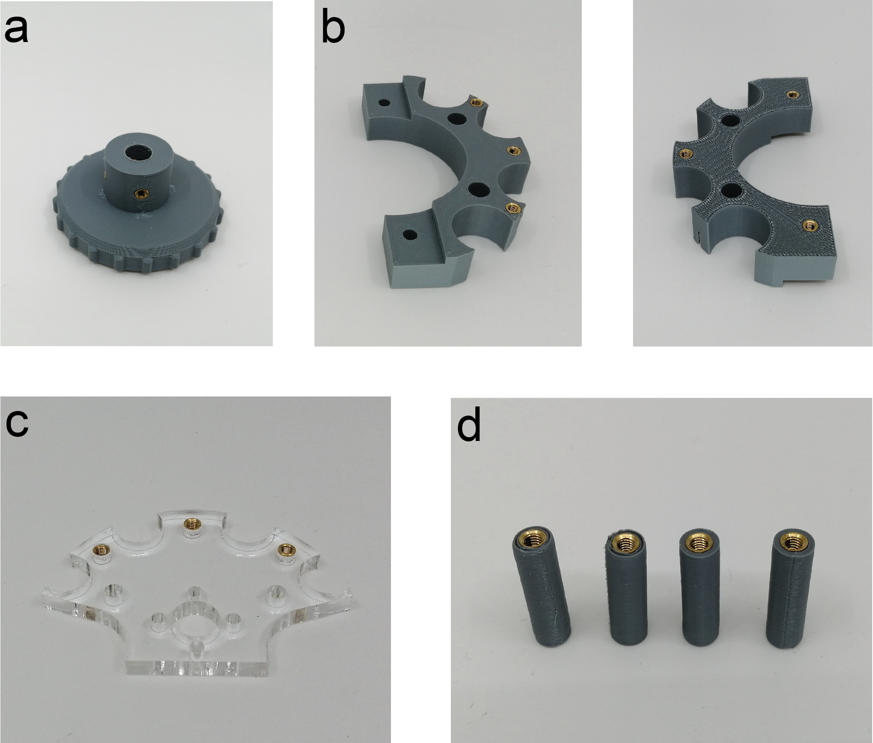
Assembly instructions/Threaded inserts.png
