FrancisCrickInstitute/Four_channel_syringe_pump/Design files/Inventor/Four channel pump assembly.png

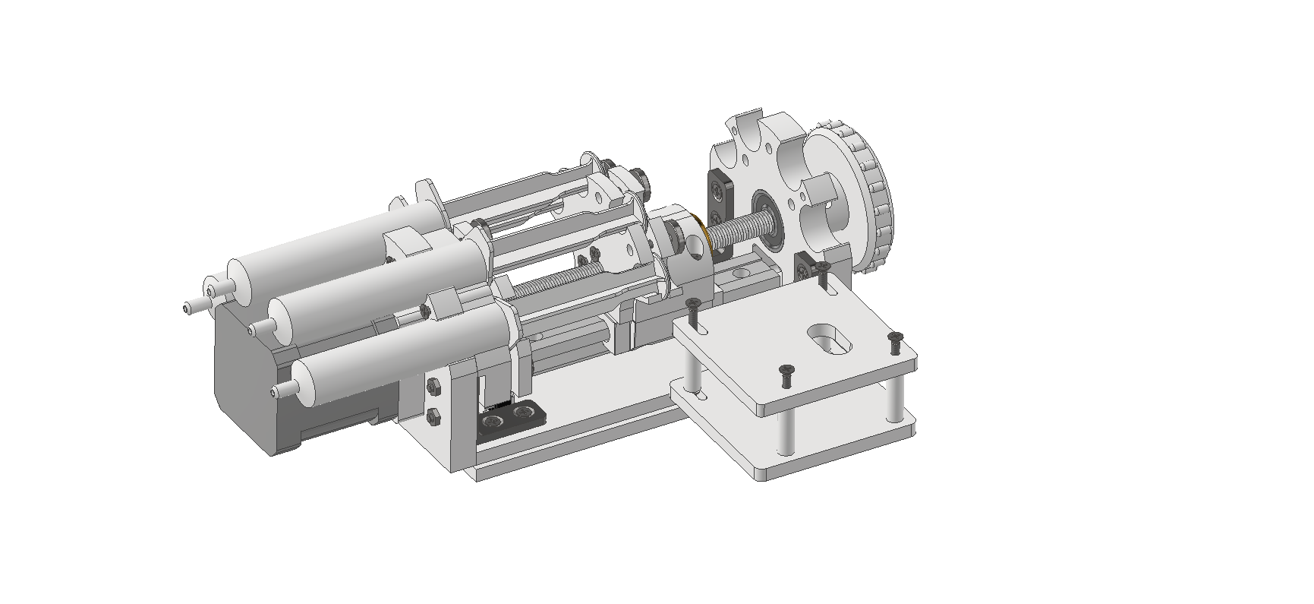
Design files/Inventor/Four channel pump assembly.png
