FrancisCrickInstitute/Four_channel_syringe_pump/Figures/Four channel pump assembly dimensions 2.png

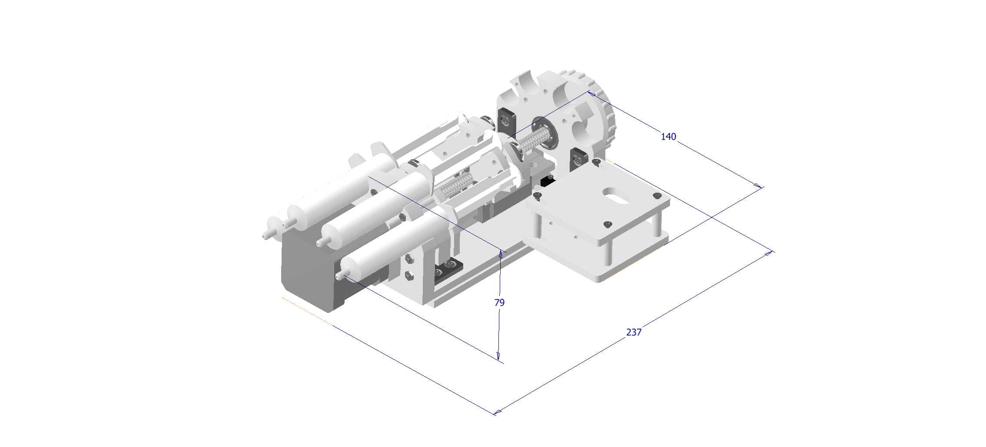
Figures/Four channel pump assembly dimensions 2.png
