FrancisCrickInstitute/Four_channel_syringe_pump/Data/4ch syringe performance.png

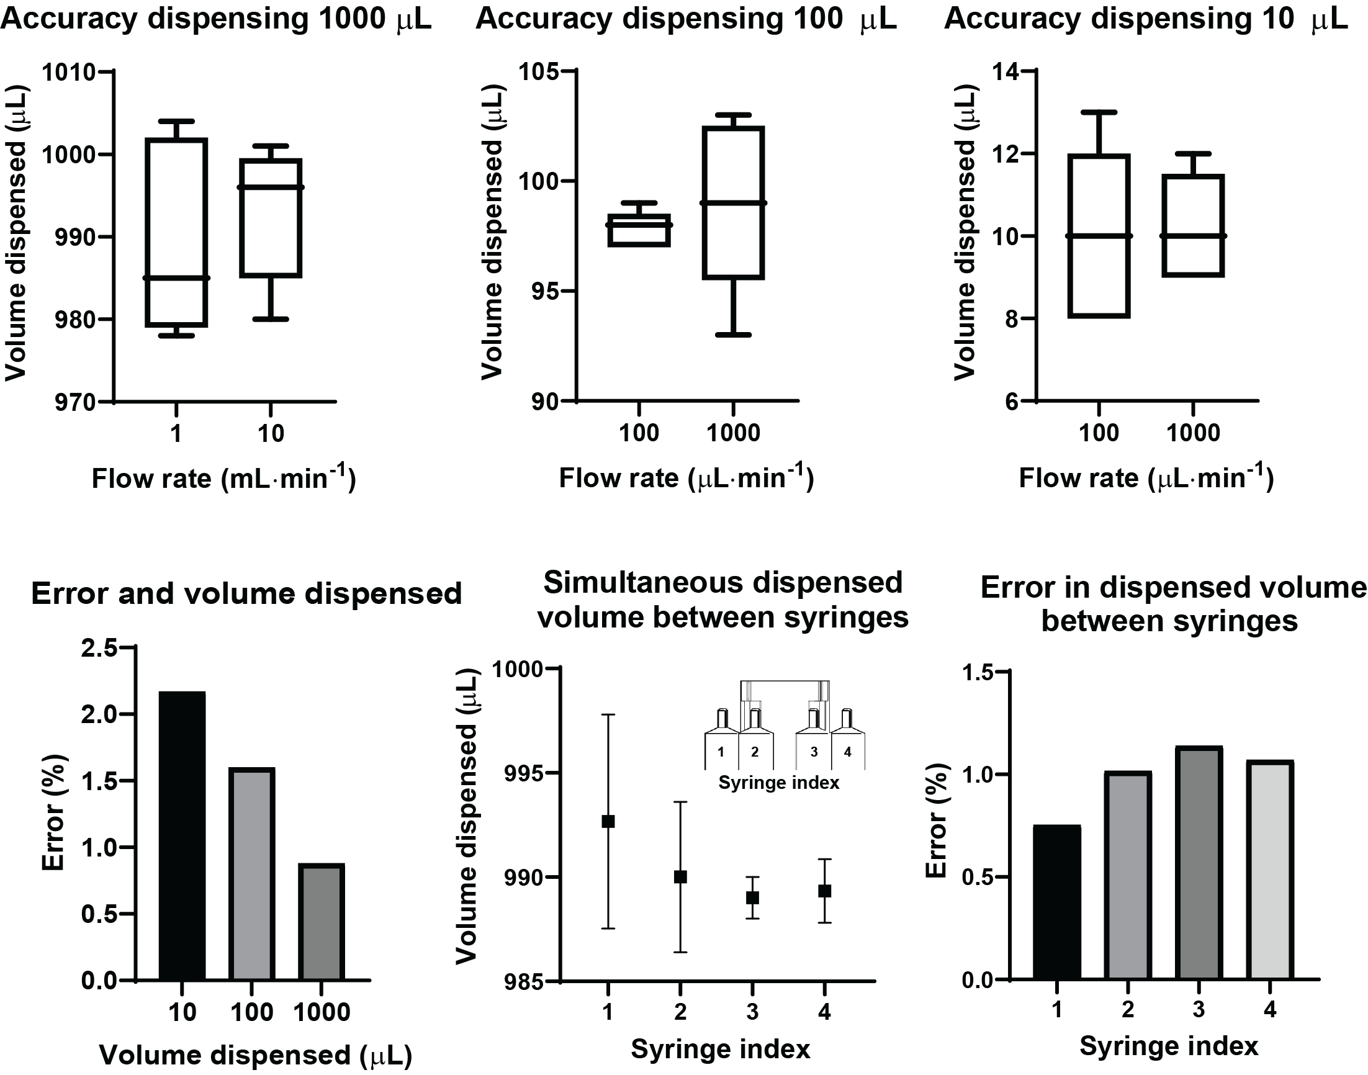
Data/4ch syringe performance.png
