FrancisCrickInstitute/Four_channel_syringe_pump/(list of files, drawings)

Other design files:
Design files/PCB/EasyEDA/1-PCB_PCB_2020-09-28_16-45-37.json
Design files/PCB/EasyEDA/1-Schematic_stepper-controller.json
