FrancisCrickInstitute/Four_channel_syringe_pump/(commit log)

2022-02-14 Second Commit
    [10 mL syringe plunger.ipt, 10 mL syringe.ipt, 4ch syringe pump.stp, Back wall.dxf, Back wall.ipt, Back wall.stl, Base.0002.ipt, Base.dxf]
2022-02-14 Assembly instructions 1
2022-02-15 BOM & PnP
    [BOM_PCB.csv, Bill of materials.xlsx, PickAndPlace_PCB.csv]
2022-02-15 Assembly instructions 2
    [Bill of materials.xlsx]
2022-02-16 Ipt assembly
    [10 mL syringe plunger.0001.ipt, 10 mL syringe plunger.0003.ipt, 10 mL syringe plunger.0004.ipt, 10 mL syringe plunger.ipt, 10 mL syringe.0002.ipt, 10 mL syringe.ipt, Cart.0001.ipt, Cart.ipt]
2022-02-16 Barrel jack
    [Bill of materials.xlsx]
